ainyan03/smartphone-cases/galaxy-z-fold7/3mf/galaxy-z-fold7-case.3mf

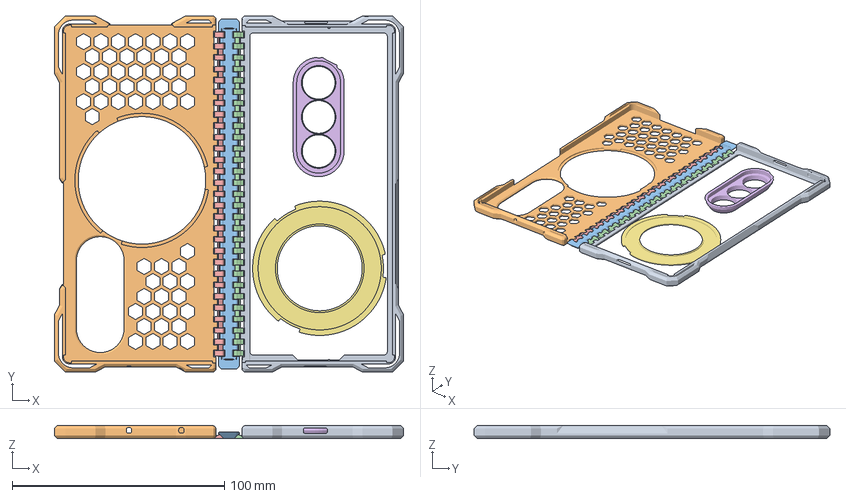
[picture p7: CAD file, 2026-10-30]
galaxy-z-fold7/3mf/galaxy-z-fold7-case.3mf
164.5 x 167.6 x 6.00 mm
case-right
case-left
guard
link-right
link-left
camera-guard
magsafe-holder
