ainyan03/smartphone-cases/galaxy-z-fold7/stl/galaxy-z-fold7-guard.stl

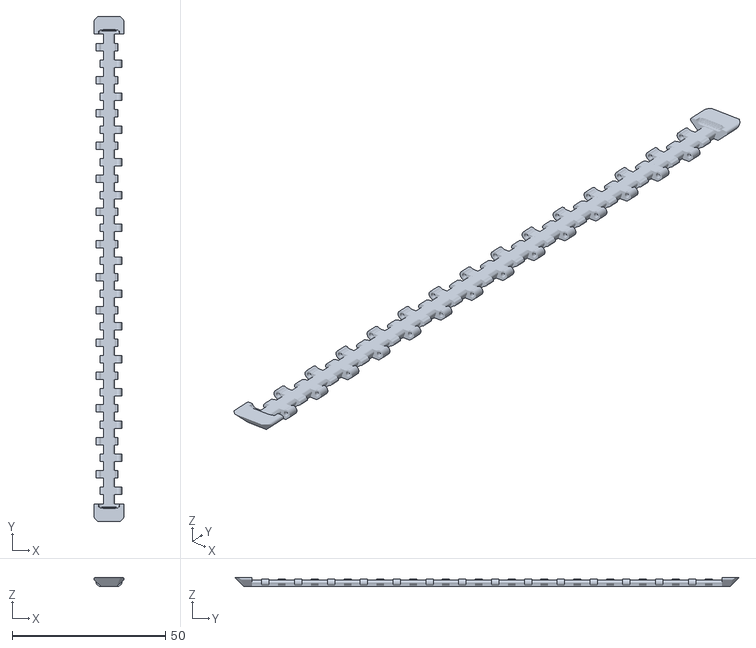
[picture p8: CAD file, 2026-10-30]
galaxy-z-fold7/stl/galaxy-z-fold7-guard.stl
9.90 x 164.8 x 3.00
