ainyan03/smartphone-cases/galaxy-z-fold7/stl/galaxy-z-fold7-link-right.stl

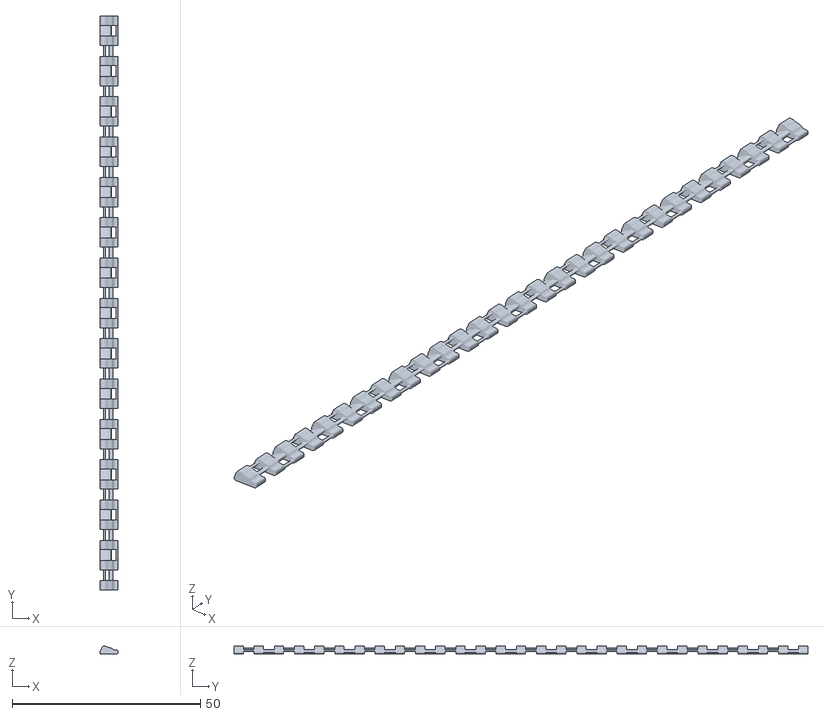
[picture p9: CAD file, 2026-10-30]
galaxy-z-fold7/stl/galaxy-z-fold7-link-right.stl
4.85 x 152.4 x 2.06
