ainyan03/smartphone-cases/galaxy-z-fold7/stl/galaxy-z-fold7-camera-guard.stl

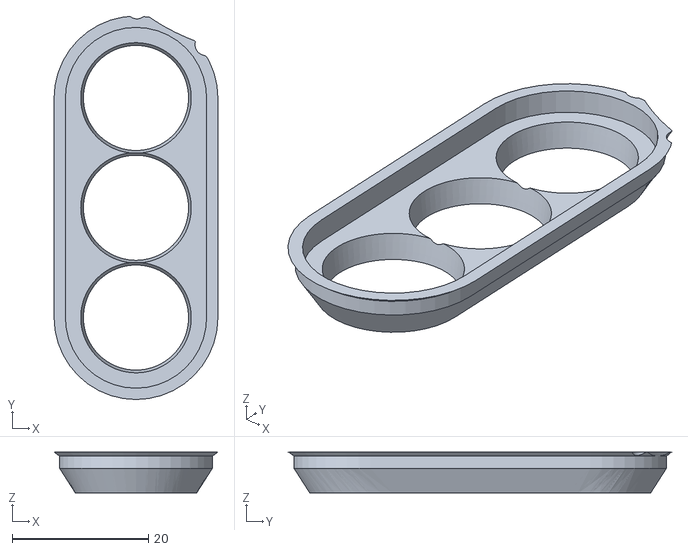
[picture p11: CAD file, 2026-10-30]
galaxy-z-fold7/stl/galaxy-z-fold7-camera-guard.stl
24.0 x 56.2 x 6.00
