ainyan03/smartphone-cases/galaxy-z-fold7/stl/galaxy-z-fold7-case-right.stl

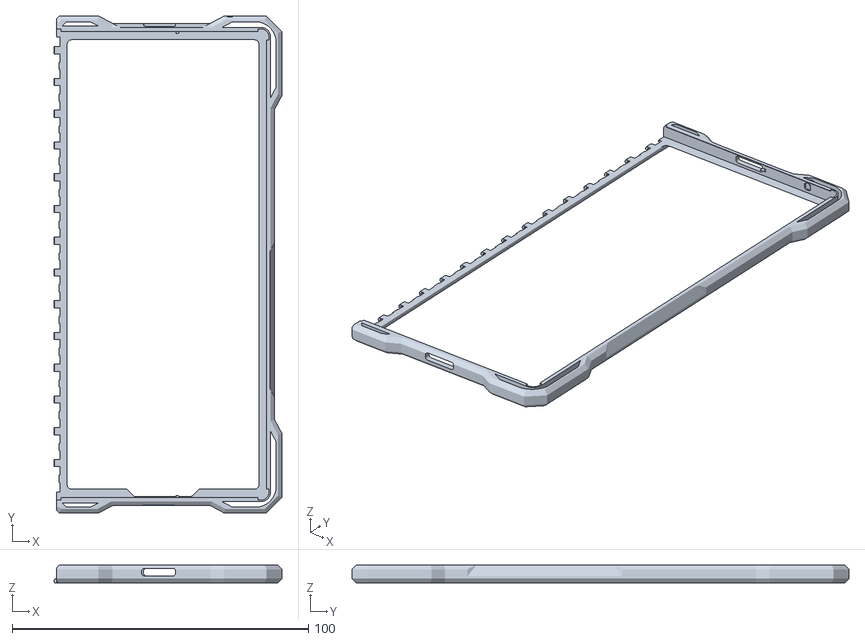
[picture p12: CAD file, 2026-10-30]
galaxy-z-fold7/stl/galaxy-z-fold7-case-right.stl
76.8 x 167.6 x 6.00
