ainyan03/smartphone-cases/galaxy-z-fold7/stl/galaxy-z-fold7-link-left.stl

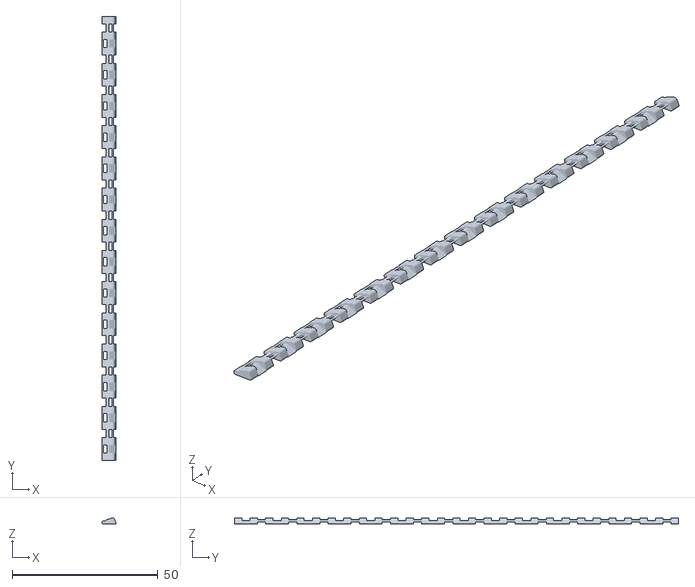
[picture p13: CAD file, 2026-10-30]
galaxy-z-fold7/stl/galaxy-z-fold7-link-left.stl
4.84 x 152.4 x 2.05
