ainyan03/smartphone-cases/galaxy-z-fold7/stl/galaxy-z-fold7-magsafe-holder-1.0.stl

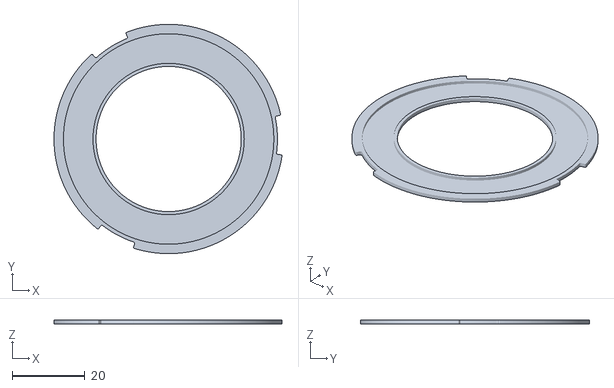
[picture p14: CAD file, 2026-10-30]
galaxy-z-fold7/stl/galaxy-z-fold7-magsafe-holder-1.0.stl
62.9 x 63.2 x 1.00
