ainyan03/smartphone-cases/(list of files, cad)

Other CAD files:
galaxy-z-fold7/3mf/galaxy-z-fold7-case-bambu.3mf
