ainyan03/smartphone-cases/(commit log)

2026-10-22 Add Galaxy Z Fold7 hinge-integrated case v1.0
    [camera-guard.stl, case-left.stl, case-right.stl, fold7-case-bambu.3mf, fold7-case.3mf, guard.stl, link-left.stl, link-right.stl]
2026-10-23 Galaxy Z Fold7: prefix file names with the model name, name the standard MagSafe holder 1.0
    [fold7-case-bambu.3mf, fold7-case.3mf, galaxy-z-fold7-camera-guard.stl, galaxy-z-fold7-case-bambu.3mf, galaxy-z-fold7-case-left.stl, galaxy-z-fold7-case-right.stl, galaxy-z-fold7-case.3mf, galaxy-z-fold7-guard.stl]
2026-10-25 Galaxy Z Fold7 v1.2: tapered camera guard, smoother hinge cover ends, fixes
    - Camera guard: tapered outer shape printed upside down (lens-side end on the bed), with a sloped flange and a matching sloped seat in the left case. Not compatible with v1.1 or older parts.
    - Back plate: hexagon cutouts aligned to the flash hole (6.55 across flats).
    - Bottom speaker slot: the latch nub moved to match the top slot, and the opening widened by 0.8 mm.
    - Hinge cover: trapezoid end sections so the closed outline has no step.
    - Corner bumpers: the sloped base follows the same trapezoid section as the side walls.
    - Camera cutouts moved 0.05 mm away from the fold.
    - Speaker-side end wall keeps its full thic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
    [galaxy-z-fold7-camera-guard.stl, galaxy-z-fold7-case-bambu.3mf, galaxy-z-fold7-case-left.stl, galaxy-z-fold7-case-right.stl, galaxy-z-fold7-case.3mf, galaxy-z-fold7-guard.stl, galaxy-z-fold7-link-left.stl, galaxy-z-fold7-magsafe-holder-1.0.stl]
2026-10-25 Galaxy Z Fold7: photos of the v1.2 print, add a camera guard close-up
2026-10-26 Galaxy Z Fold7 v1.3: hinge cover ends, rounded opening edges, longer corner bumpers
    - Hinge cover: the ends are trimmed to 3.00 mm so the case back no longer
    presses them down and bends them when fully open.
    - Hinge-side edges of the case halves are flush (no small step between the
    case body, the end wall and the corner bumper).
    - USB and side-button openings: the tapered wall ends are blunted and
    rounded instead of ending in a sharp edge.
    - Edge chamfers next to the side buttons and the speaker fade in gradually
    instead of ending in a step.
    - Corner bumpers are longer along the sides; the USB opening is 26 mm wide
    (was 31 mm), so the bumpers on the end faces are 2.5 mm longer as w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
    [galaxy-z-fold7-case-bambu.3mf, galaxy-z-fold7-case-left.stl, galaxy-z-fold7-case-right.stl, galaxy-z-fold7-case.3mf, galaxy-z-fold7-guard.stl]
2026-10-29 Galaxy Z Fold7 v1.4: thinner back plate (1.4 mm), 14-link hinge, slanted earpiece notch, MagSafe holder seated on a ledge with three keys, wider wall between the camera guard and the MagSafe opening;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
    [galaxy-z-fold7-camera-guard.stl, galaxy-z-fold7-case-bambu.3mf, galaxy-z-fold7-case-left.stl, galaxy-z-fold7-case-right.stl, galaxy-z-fold7-case.3mf, galaxy-z-fold7-guard.stl, galaxy-z-fold7-link-left.stl, galaxy-z-fold7-link-right.stl]
2026-10-29 Galaxy Z Fold7 v1.5: larger MagSafe ledge and holder (62 mm) so the keys are easier to see
    [galaxy-z-fold7-camera-guard.stl, galaxy-z-fold7-case-bambu.3mf, galaxy-z-fold7-case-left.stl, galaxy-z-fold7-case.3mf, galaxy-z-fold7-magsafe-holder-1.0.stl]
2026-10-29 Galaxy Z Fold7: photos of the v1.5 print, add a photo of the open hinge side
2026-10-30 Galaxy Z Fold7 v1.6: MagSafe opening 0.5 mm away from the camera, 60 mm opening and 63.2 mm ledge, flat 1.0 mm holder for magnet or metal rings up to 57.6 mm OD; link plates lie flat against the case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
    [galaxy-z-fold7-camera-guard.stl, galaxy-z-fold7-case-bambu.3mf, galaxy-z-fold7-case-left.stl, galaxy-z-fold7-case-right.stl, galaxy-z-fold7-case.3mf, galaxy-z-fold7-guard.stl, galaxy-z-fold7-link-left.stl, galaxy-z-fold7-link-right.stl]
